Dilip2204/CROC-SoC/results/openroad/reports/croc.final.congestion.png

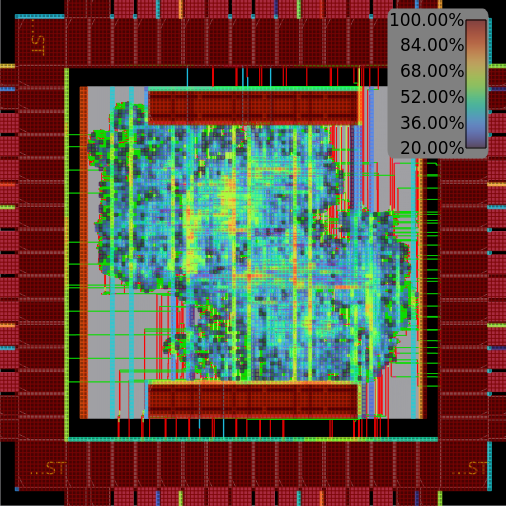
results/openroad/reports/croc.final.congestion.png
